wooseokkim1992-byte/firmware_project/control-stm32/MyApp/ap/apMain.c

#include "apMain.h"
#include "ksh_driver/relay.h"
#include "myBt_Uart.h"

#include "hw/sjh_driver/mpu6050.h"
#include "hw/sjh_driver/vibration.h"
#include "hw/sjh_driver/vibration_state.h"

#include "hw/kws_driver/kws_adc.h"
#include "hw/kws_driver/sound_level.h"
#include "hw/kws_driver/sound_offset.h"
#include "myBt.h"
#include <stdbool.h>
#include <stdint.h>
#include <stdio.h>

// sound 측정에 필요한 데이터 목록
static int16_t sound_centered_samples[ADC_WINDOW_SIZE];
static uint16_t sound_dc_offset = 0U;
volatile sound_level_data_t sound_level_result = {0};
volatile bool relay_state = true;

/* Sound NORMAL baseline / Z-score detector test parameters.
 * Adjust these values after collecting data from the assembled rotor. */
static sound_level_detector_config_t sound_level_detector_config = {
    .rms_warning_z = 1.5f,
    .peak_warning_z = 4.8f,
    .rms_normal_z = 1.4f,
    .peak_normal_z = 4.0f,
    .stddev_epsilon = 1.0f,
    .warning_persistence = 3U,
    .normal_persistence = 5U};

/* Live Watch variables for the latest sound detector result. */
static sound_level_detector_data_t sound_level_detector_data = {0};
volatile sound_level_state_t sound_current_state = SOUND_LEVEL_STATE_NORMAL;
static bool sound_level_state_changed = false;
static bool sound_level_detector_configured = false;
volatile bool kill_request = false;
extern volatile bt_rx_state_t bt_rx_state;
/*
 * ============================================================
 * Control STM32 - Application Main
 * ============================================================
 *
 * 현재 구현
 *
 * 1.1 MPU6050 센서 제어
 * 1.2 진동 데이터 처리
 *
 * 데이터 흐름
 *
 * MPU6050
 *     ↓
 * accel_x / accel_y / accel_z
 *     ↓
 * vibration_update()
 *     ↓
 * Mean / RMS / Peak
 *     ↓
 * vibration_value
 *
 *
 * 다음 단계
 *
 * 1.3 vibration_state.c
 *
 * vibration_value를 이용하여
 *
 * NORMAL
 * WARNING
 * DANGER
 *
 * 상태를 판단한다.
 * ============================================================
 */

/*
 * MPU6050 데이터
 */
static mpu6050_data_t mpu_data = {0};

/*
 * 진동 처리 결과
 *
 * Live Watch에서
 *
 * vibration_data.vibration_rms
 * vibration_data.vibration_peak
 *
 * 등을 확인할 수 있다.
 */
volatile vibration_data_t vibration_data = {0};

/*
 * 진동 상태 판정 결과
 *
 * Live Watch에서
 *
 * vibration_state_data.current_state
 * vibration_state_data.candidate_state
 * vibration_state_data.candidate_count
 * vibration_state_data.change_count
 *
 * 등을 확인할 수 있다.
 */

/*
 * ============================================================
 * 진동 상태 판정 임시 테스트 설정
 * ============================================================
 *
 * 아래 Threshold 값은 상태 판정 로직 검증용 임시값이다.
 *
 * 실제 FAN / 발전기 구조의 최종 Threshold가 아니다.
 *
 * 실제 회전체 조립 후
 * NORMAL / WARNING / DANGER 상태의 RMS 데이터를
 * 반복 측정한 뒤 반드시 다시 설정한다.
 *
 * 안정 동작 확인값:
 * WARNING : 0.2 g
 * DANGER  : 0.5 g
 * ============================================================
 */
static vibration_state_config_t vibration_state_config = {
    .warning_threshold = 0.2f,
    .danger_threshold = 0.5f,
    .hysteresis = 0.01f,
    .persistence_count = 1U};

volatile vibration_state_data_t vibration_state_data = {0};

/*
 * 새로운 진동 Window가
 * 만들어졌는지 확인.
 */
static bool vibration_updated = false;

/*
 * 가장 최근 상태 변경 여부.
 */
static bool vibration_state_changed = false;

/*
 * MPU6050 초기화 상태
 */
volatile bool mpu_init_status = false;

/*
 * MPU6050 Read 상태
 */
static bool mpu_read_status = false;

/*
 * MPU6050 Read 성공 횟수
 */
static uint32_t mpu_read_count = 0U;

/*
 * MPU6050 Read Error 횟수
 */
static uint32_t mpu_error_count = 0U;

/*
 * MPU6050 연속 실패 횟수
 */
static uint8_t mpu_fail_count = 0U;

/*
 * MPU6050 Driver 상태
 */
static mpu6050_status_t mpu_driver_status = MPU6050_STATUS_NOT_INITIALIZED;

/*
 * MPU6050 Sampling
 *
 * Application Read Period
 *
 * = 800ms (약 1.25Hz)
 */
#define MPU_READ_PERIOD_MS 800U
#define MPU_REINIT_PERIOD_MS 1000U
#define MPU_INIT_RETRY_COUNT 3U
#define MPU_MAX_CONSECUTIVE_FAILURES 3U

/*
 * UART Debug 출력 주기
 */
#define DEBUG_PRINT_PERIOD_MS 1000U

/* 부팅 중 일시적인 I2C 오류가 발생해도 센서 초기화를 다시 시도한다. */
static bool mpu6050_initialize_with_retry(void) {
  for (uint8_t attempt = 0U; attempt < MPU_INIT_RETRY_COUNT; attempt++) {
    bool initialized = (attempt == 0U) ? mpu6050_init() : mpu6050_reinit();

    if (initialized) {
      return true;
    }

    if ((attempt + 1U) < MPU_INIT_RETRY_COUNT) {
      HAL_Delay(100U);
    }
  }

  return false;
}

static void sound_process_window(const uint16_t *raw_samples) {
  if (!sound_offset_remove_window(raw_samples, sound_centered_samples,
                                  ADC_WINDOW_SIZE, &sound_dc_offset)) {
    return;
  }

  if (!sound_level_calculate(sound_centered_samples, ADC_WINDOW_SIZE,
                             &sound_level_result)) {
    return;
  }

  sound_level_state_changed = sound_level_detector_update(&sound_level_result);
  sound_level_detector_get_data(&sound_level_detector_data);

  printf(">sound_offset:%u\r\n", sound_dc_offset);
  printf(">sound_mean_abs:%.2f\r\n", sound_level_result.mean_absolute);
  printf(">sound_rms:%.2f\r\n", sound_level_result.rms);
  printf(">sound_peak:%u\r\n", sound_level_result.peak);
  printf(">sound_rms_z:%.2f\r\n", sound_level_detector_data.rms_z_score);
  printf(">sound_peak_z:%.2f\r\n", sound_level_detector_data.peak_z_score);

  if (sound_level_state_changed) {
    sound_current_state = sound_level_detector_data.current_state;
    printf("[SOUND STATE] %s\r\n",
           sound_level_state_get_name(sound_current_state));
  }
}

/*
 * ============================================================
 * Application Initialization
 * ============================================================
 */
void apInit(void) {
  /*
   * UART 초기화
   */
  // uartInit();

  // BT 모듈 재설정 ( 나재우 문의 바람 복잡)
  // bt_Reset();
  /*
   * 현재 I2C Device 확인.
   *
   * 프로젝트 초기 Debug 용도로 유지.
   */
  volatile uint32_t test_packet_size = sizeof(lcd_display_data_t);
  volatile uint32_t test_enum_size = sizeof(system_state_t);
  volatile uint32_t test_bool_size = sizeof(bool);

  relay_init();
  btInit();

  /*
   * MPU6050 초기화
   */
  mpu_init_status = mpu6050_initialize_with_retry();

  /*
   * MPU6050 상태 확인
   */
  mpu_driver_status = mpu6050_get_status();

  if (!mpu_init_status) {
    printf("[MPU6050] Init failed: status=%d i2c=0x%08lX reg=0x%02X\r\n",
           (int)mpu_driver_status, (unsigned long)mpu6050_get_last_i2c_error(),
           mpu6050_get_failed_register());
  }

  /*
   * 진동 처리 모듈 초기화
   */
  vibration_init();

  /*
   * 진동 상태 판정 모듈 초기화
   */
  vibration_state_init();

  /*
   * 진동 상태 판정 Test 설정 적용
   */
  vibration_state_set_config(&vibration_state_config);

  vibration_state_get_data(&vibration_state_data);

  /* Sound detector starts in NORMAL and first learns 20 baseline windows. */
  sound_level_detector_init();
  sound_level_detector_configured =
      sound_level_detector_set_config(&sound_level_detector_config);
  sound_level_detector_get_data(&sound_level_detector_data);
  sound_current_state = sound_level_detector_data.current_state;

  /*
   * 초기 상태를 Application 변수에 복사
   */
  vibration_state_get_data(&vibration_state_data);
  /*
   * MPU6050 초기화 결과 출력
   */
  // if (mpu_init_status) {
  //   printf("\r\n");

  //   printf("============================\r\n");

  //   printf(" Control STM32 Start\r\n");

  //   printf("============================\r\n");

  //   printf("[MPU6050] Init Success\r\n");

  //   printf("[MPU6050] WHO_AM_I : 0x%02X\r\n", mpu6050_get_chip_id());

  //   printf("[MPU6050] Sample Rate : %lu Hz\r\n",
  //          (unsigned long)MPU6050_SAMPLE_RATE_HZ);

  //   printf("[VIBRATION] Window : %u Samples\r\n", VIBRATION_WINDOW_SIZE);
  // } else {
  //   printf("\r\n");

  //   // printf("[MPU6050] Init Failed\r\n");

  //   // printf("[MPU6050] Status : %d\r\n", (int)mpu_driver_status);
  // }
  if (!sound_level_detector_configured) {
    printf("[SOUND] Invalid detector configuration\r\n");
  }

  if (adc_init()) {
    printf("Start Detecting Sound Signals\r\n");
  } else {
    printf("Failed to start Sound ADC\r\n");
  }
}

/*
 * ============================================================
 * Application Main
 * ============================================================
 */
void apMain(void) {
  /*
   * MPU6050 마지막 읽기 시간
   */
  uint32_t tick_mpu = 0U;

  /*
   * Debug 마지막 출력 시간
   */
  uint32_t tick_debug = 0U;

  /*
   * MPU6050 재초기화 시간
   */
  uint32_t tick_reinit = 0U;

  /*
   * 현재 System Tick
   */
  uint32_t current_tick = 0U;

  uint32_t tick_125 = 0;

  uint32_t tick_2000 = 0;
  bool b_BtTest = true;

  while (1) {
    /*
     * 현재 시간
     *
     * 단위 : ms
     */
    if (vibration_state_data.current_state == VIBRATION_STATE_DANGER) {
      relay_off();
    }
    current_tick = HAL_GetTick();
    /*
     * DMA 콜백이 100ms마다 준비한 구간을 즉시 처리한다.
     */
    if (current_tick - tick_2000 >= 2000) {
      tick_2000 = current_tick;
      if (bt_rx_state == BT_RX_HEADER) {

        b_BtTest = bt_sendHeader();
      }
    }

    if (current_tick - tick_125 >= 125) {
      tick_125 = current_tick;
      if (adc_half_ready) {
        adc_half_ready = false;
        sound_process_window(&adc_dma_buffer[0]);
      }

      if (adc_full_ready) {
        adc_full_ready = false;
        sound_process_window(&adc_dma_buffer[ADC_WINDOW_SIZE]);
      }
    }

    /*
     * ====================================================
     * MPU6050 Sampling
     * ====================================================
     *
     * 약 800ms마다 실행
     *
     * ≈ 1.25Hz
     */

    if ((current_tick - tick_mpu) >= MPU_READ_PERIOD_MS) {
      tick_mpu = current_tick;

      /*
       * MPU6050 초기화 성공 상태에서만 Read
       */
      if (mpu_init_status) {
        mpu_read_status = mpu6050_read(&mpu_data);

        /*
         * MPU6050 Read 성공
         */
        if (mpu_read_status) {
          mpu_read_count++;

          mpu_fail_count = 0U;

          mpu_driver_status = MPU6050_STATUS_OK;

          /*
           * ==========================================
           * 1.2 진동 데이터 처리
           * ==========================================
           *
           * MPU6050에서 읽은
           *
           * accel_x
           * accel_y
           * accel_z
           *
           * 를 vibration 모듈에 전달한다.
           *
           * 반환값 true는
           * 진동 Window 결과가 새로 만들어졌다는 뜻.
           */
          /*
           * 진동 데이터 처리.
           *
           * true:
           * 새로운 진동 Window 결과가 만들어짐
           *
           * false:
           * 아직 Window 수집 중
           */
          vibration_updated = vibration_update(
              mpu_data.accel_x, mpu_data.accel_y, mpu_data.accel_z);

          /*
           * 최신 진동 처리 결과 복사
           */
          vibration_get_data(&vibration_data);

          /*
           * ========================================================
           * 1.3 진동 상태 판정
           * ========================================================
           *
           * 새로운 RMS 결과가 만들어졌을 때만
           * 상태 판정을 한 번 실행한다.
           */
          if (vibration_updated) {
            vibration_state_t previous_vibration_state =
                vibration_state_data.current_state;

            vibration_state_changed =
                vibration_state_update(vibration_data.vibration_value);

            vibration_state_get_data(&vibration_state_data);

            if (vibration_state_changed) {
              printf(
                  "[VIBRATION STATE] %s -> %s (RMS=%.5f g)\r\n",
                  vibration_state_get_name(previous_vibration_state),
                  vibration_state_get_name(vibration_state_data.current_state),
                  vibration_state_data.vibration_value);

              if (vibration_state_data.current_state ==
                  VIBRATION_STATE_DANGER) {
                relay_off();
                printf("[RELAY] OFF: vibration DANGER\r\n");
              }
            }
          }
        }

        /*
         * MPU6050 Read 실패
         */
        else {
          mpu_error_count++;

          mpu_fail_count++;

          mpu_driver_status = mpu6050_get_status();

          /*
           * 3회 연속 실패
           */
          if (mpu_fail_count >= MPU_MAX_CONSECUTIVE_FAILURES) {
            mpu_init_status = false;

            mpu_read_status = false;

            mpu_fail_count = 0U;

            tick_reinit = current_tick;
          }
        }
      }
    }

    /*
     * ====================================================
     * MPU6050 재초기화
     * ====================================================
     */
    if (!mpu_init_status) {
      if ((current_tick - tick_reinit) >= MPU_REINIT_PERIOD_MS) {
        tick_reinit = current_tick;

        mpu_init_status = mpu6050_reinit();

        mpu_driver_status = mpu6050_get_status();

        if (mpu_init_status) {
          mpu_read_status = false;

          mpu_fail_count = 0U;

          tick_mpu = current_tick;

          /* 같은 loop에서 read=false를 오류로 출력하지 않도록 한다. */
          tick_debug = current_tick;

          /* 센서 Reset 후에는 기존 진동 기준값도 다시 설정한다. */
          vibration_init();
        }
      }
    }

    /*
     * ====================================================
     * Debug Print
     * ====================================================
     *
     * Sensor Read는 800ms마다 실행하지만
     * UART Print는 1초마다 실행한다.
     */
    if ((current_tick - tick_debug) >= DEBUG_PRINT_PERIOD_MS) {
      tick_debug = current_tick;

      if (mpu_read_status) {
        /*
         * MPU6050 원본 가속도
         */

        /*
         * 진동 처리 결과
         *
         * Teleplot에서도 바로 확인 가능.
         */
        printf(">vibration:%.5f\r\n"
               ">vibration_mean:%.5f\r\n"
               ">vibration_rms:%.5f\r\n"
               ">vibration_peak:%.5f\r\n",
               vibration_data.vibration_magnitude,
               vibration_data.vibration_mean, vibration_data.vibration_rms,
               vibration_data.vibration_peak);
        printf("[VIBRATION STATE] %s\r\n",
               vibration_state_get_name(vibration_state_data.current_state));
      }

      else {
        printf("[MPU6050] Error: status=%d init=%u read=%u count=%lu "
               "i2c=0x%08lX reg=0x%02X\r\n",
               (int)mpu_driver_status, mpu_init_status ? 1U : 0U,
               mpu_read_status ? 1U : 0U, (unsigned long)mpu_error_count,
               (unsigned long)mpu6050_get_last_i2c_error(),
               mpu6050_get_failed_register());
      }
    }
  }
}
