wooseokkim1992-byte/firmware_project/control-stm32/led.ioc

Mcu.UserName=STM32F411RETx
PA0-WKUP.Signal=GPIO_Input
PA1.Signal=GPIO_Input
PA10.Signal=USART1_RX
PA13.GPIO_Label=TMS
PA13.Signal=SYS_JTMS-SWDIO
PA14.GPIO_Label=TCK
PA14.Signal=SYS_JTCK-SWCLK
PA2.GPIO_Label=USART_TX
PA2.Signal=USART2_TX
PA3.GPIO_Label=USART_RX
PA3.Signal=USART2_RX
PA4.Signal=GPIO_Output
PA5.GPIO_Label=LD2 [Green Led]
PA5.Signal=GPIO_Output
PA6.Signal=S_TIM3_CH1
PA7.Signal=S_TIM3_CH2
PA8.Signal=GPIO_Output
PA9.Signal=USART1_TX
PB0.Signal=GPIO_Output
PB1.Signal=ADCx_IN9
PB13.Signal=GPIO_Output
PB3.GPIO_Label=SWO
PB3.Signal=SYS_JTDO-SWO
PB6.Signal=S_TIM4_CH1
PB8.Signal=I2C1_SCL
PB9.Signal=I2C1_SDA
PC0.Signal=GPIO_Output
PC1.Signal=GPIO_Output
PC13-ANTI_TAMP.Signal=GPXTI13
PC14-OSC32_IN.Signal=RCC_OSC32_IN
PC15-OSC32_OUT.Signal=RCC_OSC32_OUT
PC6.Signal=USART6_TX
PC7.Signal=USART6_RX
