wooseokkim1992-byte/firmware_project/operate-stm32/MyApp/kws_driver/kws_lcd.h

#pragma once
#include "main.h"

#include <stdbool.h>
#include <stdint.h>

#define LCD1602_INIT_TIME_MS 20U
#define LCD1602_ADDR (0x27U << 1)
#define LCD_RS 0x01
#define LCD_RW 0x02
#define LCD_EN 0x04
#define LCD_BL 0x08
#define LCD_D4 0x10
#define LCD_D5 0x20
#define LCD_D6 0x40
#define LCD_D7 0x80

#define LCD1602_POWER_ON_DELAY_MS 50U
#define LCD1602_ENABLE_DELAY_MS 1U
#define LCD1602_LINE_COUNT 2U
#define LCD1602_COLUMN_COUNT 16U
#define LCD1602_BUF_LEN (LCD1602_COLUMN_COUNT + 1U)
#define LCD1602_DMA_BUF_LEN                                                \
  ((LCD1602_LINE_COUNT * (LCD1602_COLUMN_COUNT + 1U)) * 4U)

bool lcd1602_init(void);
void lcd1602_send_command(uint8_t cmd);
void lcd1602_send_data(uint8_t data);

void lcd1602_clear(void);
void lcd1602_cursor(uint8_t row, uint8_t col);
void lcd1602_print(const char *str);
void lcd1602_printf(const char *fmt, ...);
void lcd1602_backlight(bool on);
void lcd1602_print_initial(const char *str);
bool lcd1602_send_dma_data(void);
bool lcd1602_update_lines_dma(const char *line1, const char *line2);
