wooseokkim1992-byte/firmware_project/control-stm32/MyApp/hw/driver/myTimer.h

#pragma once
#include "main.h"
#include "tim.h"
#include <stdint.h>

void timerInit(void);
void timerPwmStart(void);
void timerPwmStop(void);

void timerSetDuty(uint8_t duty_percent);
uint8_t timerGetDuty(void);
