wooseokkim1992-byte/firmware_project/(commit log)

2026-08-25 oled DMA 로 데이터 전송
2026-08-26 feat: implement MPU6050 sensor control
2026-08-26 feat: implement vibration data processing
    [apMain.c, vibration.c, vibration.h]
2026-08-26 feat: implement vibration state classification
    [apMain.c, vibration_state.c, vibration_state.h]
2026-08-26 rpm 측정
2026-08-26 lcd1603 초기화
2026-08-26 LCD DMA 전송 완료
2026-08-26 display manager 구현 및 lcd 에서 정식 로그 출력
2026-08-27 relay 제어
2026-08-27 relay 제어 코드 수정
    [relay.c, relay.h]
2026-08-27 1.9 수정
2026-08-27 1.8 관제 데이터 송신 코드 추가
2026-08-27 1.8 코드 압축
2026-08-27 1.9코드 압축
2026-08-28 adc 초기 설정 및 직류 전원값 제거
2026-08-28 RMS,peak 등의 측정값 계산
2026-08-28 rebase and remove error
    [myBt.c]
2026-08-28 유아트6사용, relay_off함수 추가
2026-08-28 sound 이상 발생시 상태 변경
2026-08-28 rgb led 구현 안료
2026-08-29 sound 안됨
2026-08-29 릴레이-모터 연동+사운드센서 정상 작동 확인완료
2026-08-29 oled lcd 출력형식 변경
2026-08-29 임시 push
2026-08-29 rgb led 코드 수정 및 분배
    [apMain.c, kws_display_manager.c, kws_display_manager.h, kws_led.c, kws_led.h]
2026-08-30 blue tooth 연결 완료
2026-08-30 display 상태 Emergency stop 반영
2026-08-30 restore njw driver
2026-08-30 자이로 센서 오류 수정
    [apMain.c, mpu6050.c, mpu6050.h, vibration.c, vibration.h, vibration_state.c]
