wooseokkim1992-byte/firmware_project/(notices)

Notices in the files:
operate-stm32/Core/Inc/main.h:
Copyright (c) 2026 STMicroelectronics.
All rights reserved.
This software is licensed under terms that can be found in the LICENSE file
